NgDG24/Solar-MPPT-BMS-System/Image/LTC4366/Front.png

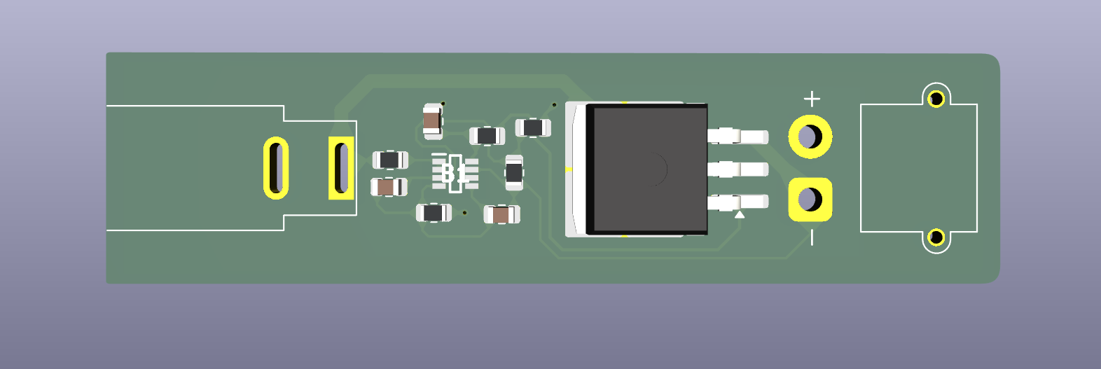
Image/LTC4366/Front.png
