NgDG24/Solar-MPPT-BMS-System/Image/LTC4162/Back.png

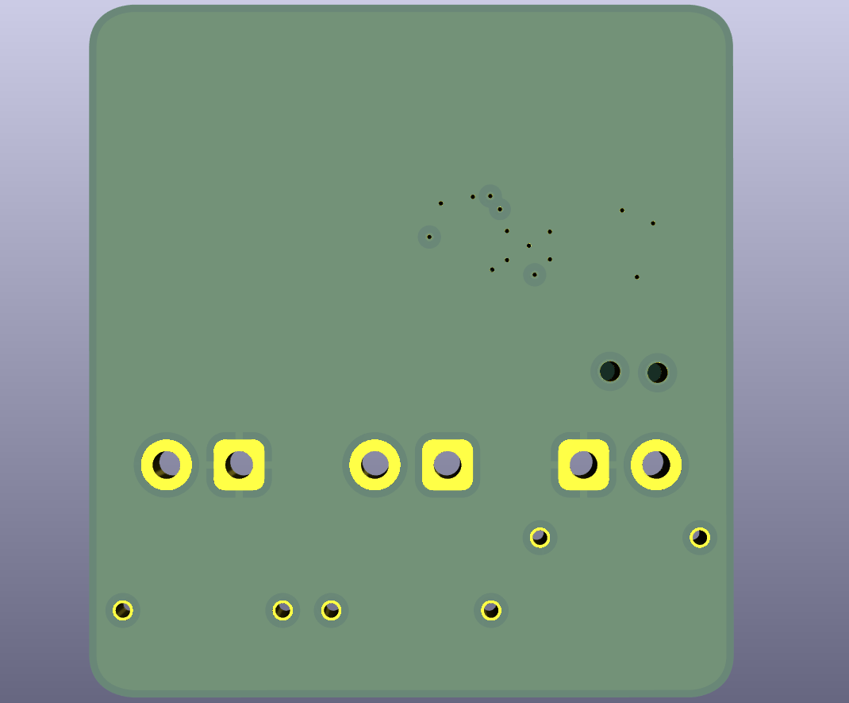
Image/LTC4162/Back.png
