NgDG24/Solar-MPPT-BMS-System/LTC4162/production/bom.csv

Designator | Footprint | Quantity | Value | LCSC Part #
B4 | QFN50P400X500X80-29N-D | 1 | LTC4162EUFD-LAD#PBF
C14 | 0805 | 1 | 4.7µF
C15 | 0805 | 1 | 1µF
C16, C17 | 0805 | 2 | 10µF
C5 | 0805 | 1 | 22nF
J1 | AMASS_XT30U-F_1x02_P5.0mm_Vertical | 1 | Conn_01x02
J2, J3 | AMASS_XT30U-M_1x02_P5.0mm_Vertical | 2 | Conn_01x02
L2 | L_Coilcraft_XAL5030-XXX | 1 | 6.8µH
NTCS0402E3103FLT2 | 0402 | 1 | 10k
Q6 | SOIC127P600X175-8N | 1 | AO4406A
Q7 | SOT-23 | 1 | 2N7002
R8 | 0805 | 1 | 10k
R9 | 0805 | 1 | 63.4k
RSNSB2 | R_Shunt_Vishay_WSK2512_6332Metric_T1.19mm | 1 | 10mΩ
RSNSI2 | R_Shunt_Vishay_WSK2512_6332Metric_T1.19mm | 1 | 16mΩ
