NgDG24/Solar-MPPT-BMS-System/MAX17302/MAX17302.csv

Reference | Qty | Value | DNP | Exclude from BOM | Exclude from Board | Footprint | Datasheet
C1,C3,C4 | 3 | 0.1 µF |  |  |  | Capacitor_SMD:C_0805_2012Metric
C2 | 1 | 0.47µF |  |  |  | Capacitor_SMD:C_0805_2012Metric
J1,J2 | 2 | Conn_01x02 |  |  |  | Connector_AMASS:AMASS_XT30U-F_1x02_P5.0mm_Vertical
J3 | 1 | Conn_01x03 |  |  |  | Connector_PinHeader_2.54mm:PinHeader_1x03_P2.54mm_Vertical_SMD_Pin1Left
Q3 | 1 | FS8205A |  |  |  | Package_SO:TSSOP-8_4.4x3mm_P0.65mm | https://aosmd.com/sites/default/files/res/data_sheets/AO4842.pdf
R1 | 1 | 10Ω |  |  |  | Resistor_SMD:R_0805_2012Metric
R2 | 1 | 10mΩ |  |  |  | Resistor_SMD:R_Shunt_Ohmite_LVK12
R3,R4 | 2 | 1k |  |  |  | Resistor_SMD:R_0805_2012Metric
TH1 | 1 | 10kΩ |  |  |  | Resistor_SMD:R_0805_2012Metric
U1 | 1 | MAX17302G+T |  |  |  | Max17302:21-0137I_T1433-2_MXM | MAX17302G+T
