NgDG24/Solar-MPPT-BMS-System/LTC4162/KiCad/User Library-XT30PW-F.STEP

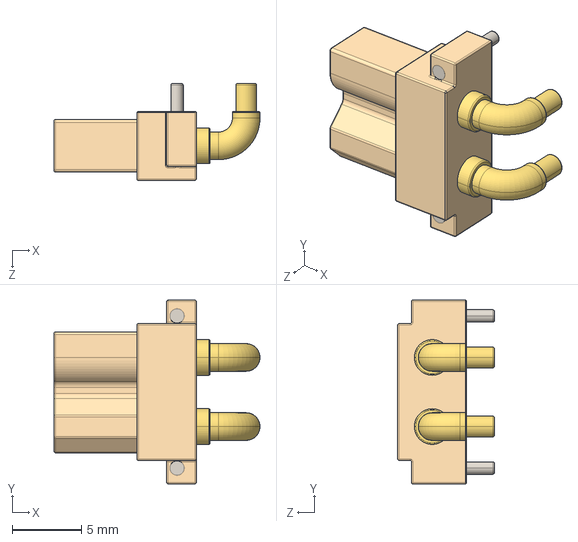
[picture p3: CAD file, 2026-10-14]
LTC4162/KiCad/User Library-XT30PW-F.STEP
14.9 x 13.3 x 7.00 mm
