NgDG24/Solar-MPPT-BMS-System/LTC4162/KiCad/FDMC86139P.stp

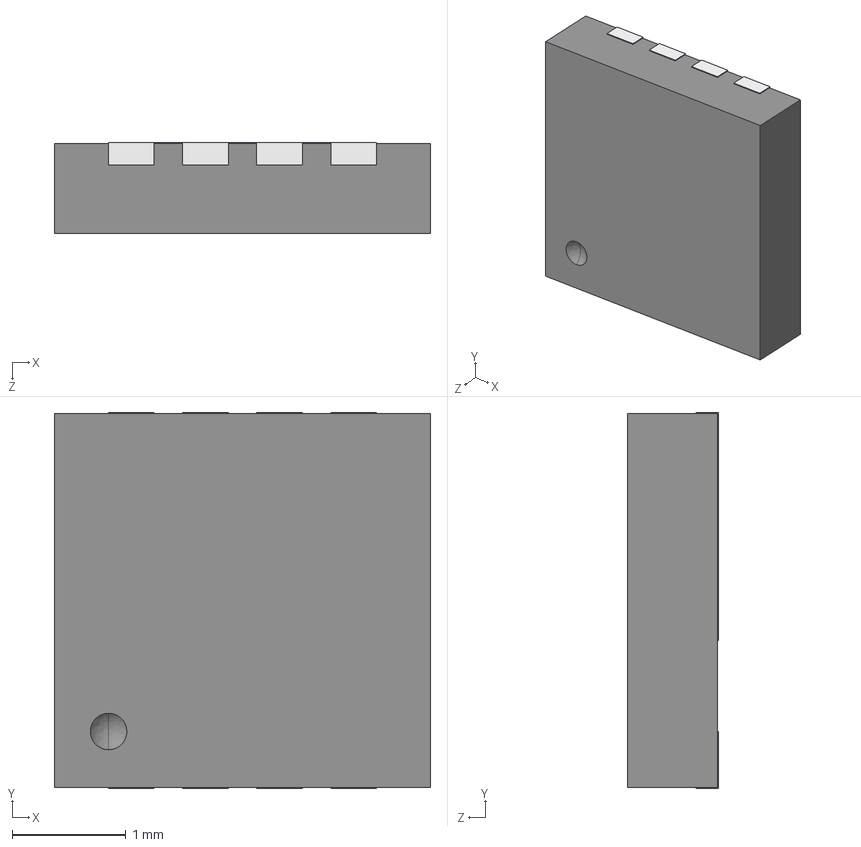
[picture p4: CAD file, 2026-10-14]
LTC4162/KiCad/FDMC86139P.stp
3.30 x 3.30 x 0.8 mm
