NgDG24/Solar-MPPT-BMS-System/LTC4162/KiCad/21-0137I_T1433-2_MXM.step

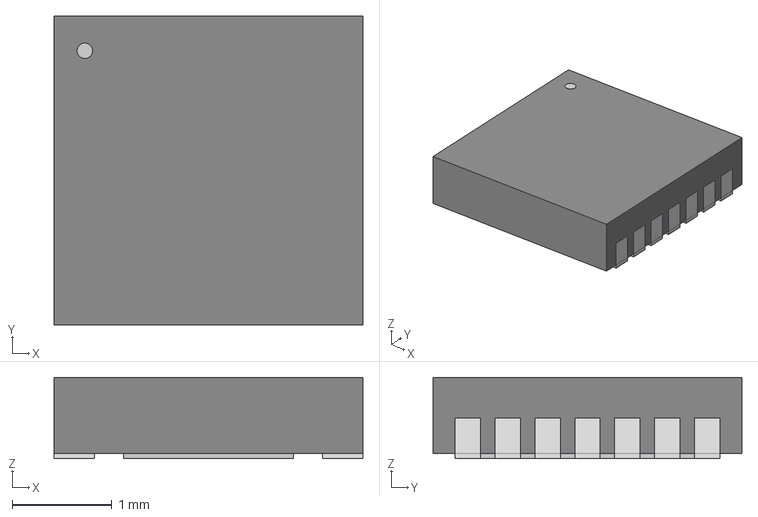
[picture p5: CAD file, 2026-10-14]
LTC4162/KiCad/21-0137I_T1433-2_MXM.step
3.10 x 3.10 x 0.815 mm
