NgDG24/Solar-MPPT-BMS-System/LTC4162/KiCad/User Library-XT30PW-M.STEP

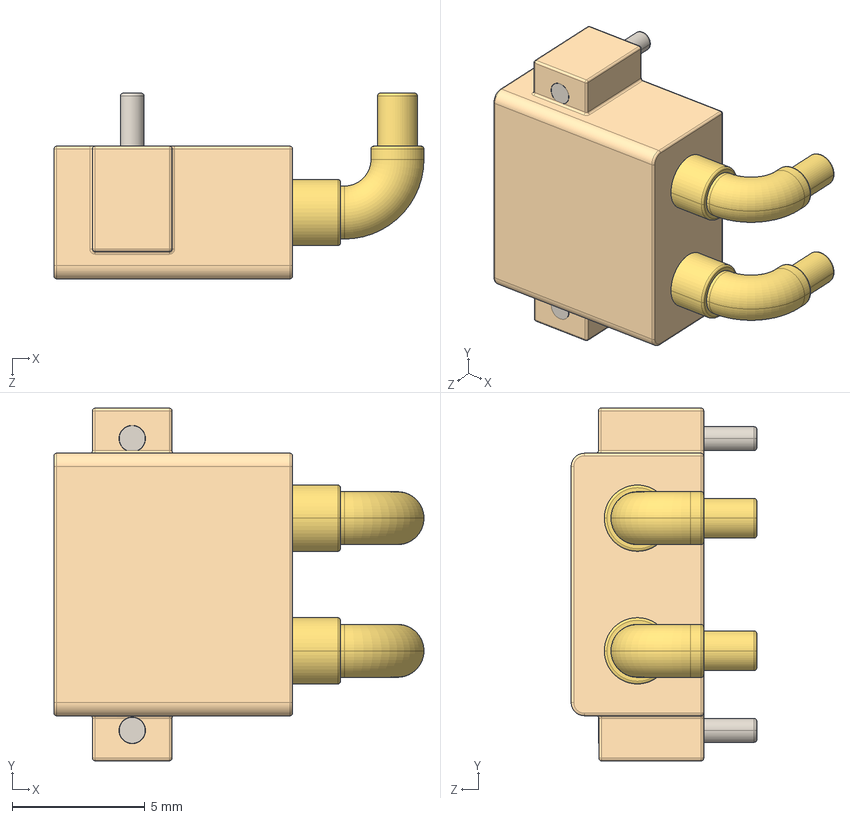
[picture p6: CAD file, 2026-10-14]
LTC4162/KiCad/User Library-XT30PW-M.STEP
13.9 x 13.3 x 7.00 mm
