NgDG24/Solar-MPPT-BMS-System/LTC4162/KiCad/Vishay_CSM2512_CSM2512S.STEP

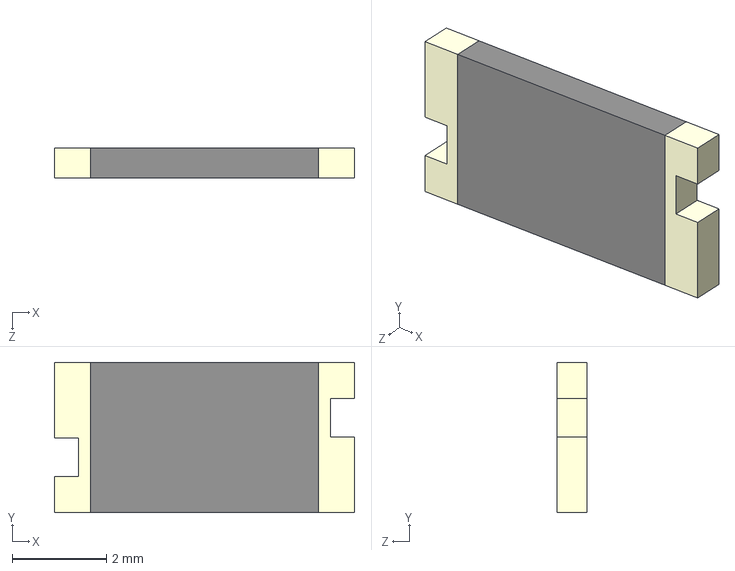
[picture p7: CAD file, 2026-10-14]
LTC4162/KiCad/Vishay_CSM2512_CSM2512S.STEP
6.35 x 3.17 x 0.635 mm
