NgDG24/Solar-MPPT-BMS-System/LTC4162/KiCad/05-08-1637_ADI.step

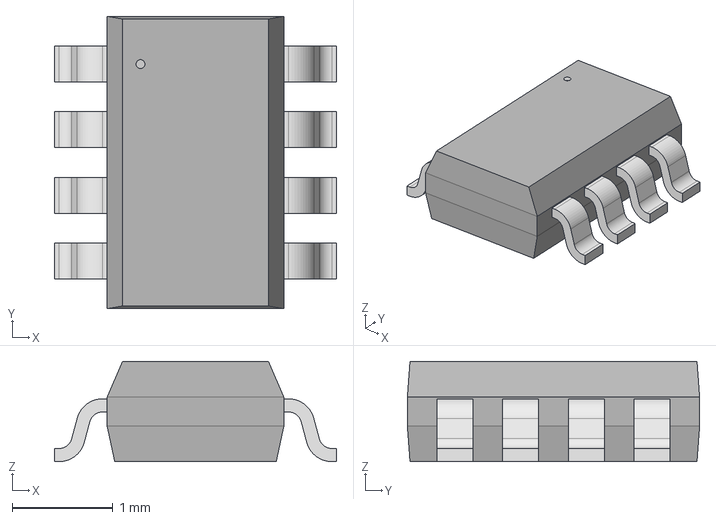
[picture p8: CAD file, 2026-10-14]
LTC4162/KiCad/05-08-1637_ADI.step
2.79 x 2.90 x 0.993 mm
