NgDG24/Solar-MPPT-BMS-System/MAX17302/MAX17302.pdf

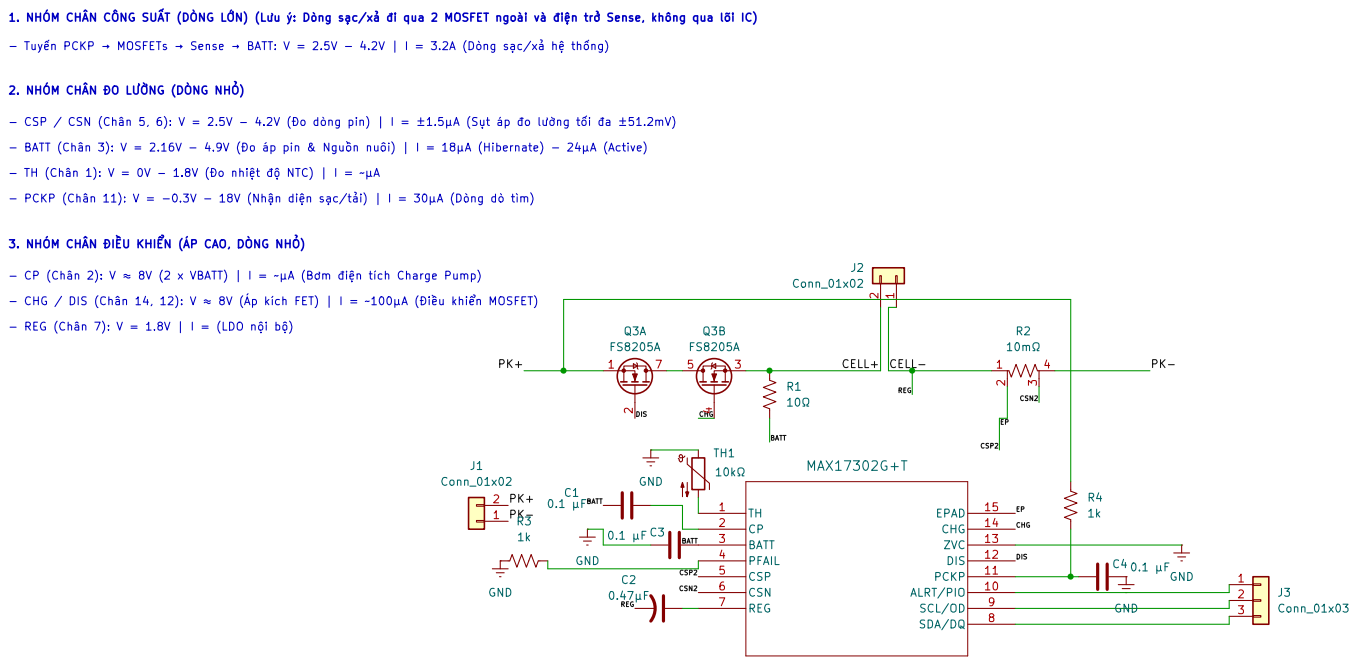
[picture p9: page 1]
