NgDG24/Solar-MPPT-BMS-System/(list of files, drawings)

Other design files:
LTC4162/temp-freerouting.dsn
