NgDG24/Solar-MPPT-BMS-System/MAX17302/MAX17302.kicad_pcb

## KiCad design MAX17302/MAX17302.kicad_pcb (2026-10-14)

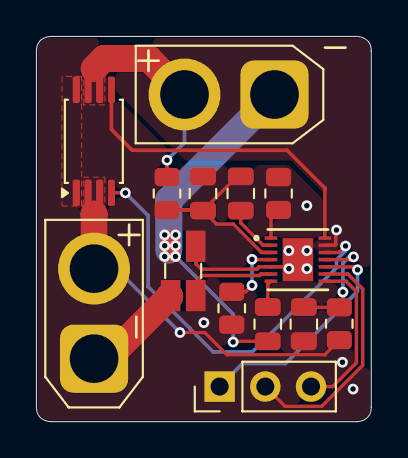
[picture p10: board MAX17302.kicad_pcb from above]

Board: 2 copper layers, 18.6 x 21.4 mm, 14 parts (0 on the bottom side), 19 nets.

Parts:
C1, C3, C4: 0.1 µF; C_0805_2012Metric
C2: 0.47µF; C_0805_2012Metric
J1, J2: Conn_01x02; AMASS_XT30U-F_1x02_P5.0mm_Vertical
J3: Conn_01x03; PinHeader_1x03_P2.54mm_Vertical
Q3: FS8205A; TSSOP-8_4.4x3mm_P0.65mm
R1: 10Ω; R_0805_2012Metric
R2: 10mΩ; R_Shunt_Ohmite_LVK12
R3, R4: 1k; R_0805_2012Metric
TH1: 10kΩ; R_0805_2012Metric
U1: MAX17302G+T; 21-0137I_T1433-2_MXM

Connections:
/BATT: C1.1, C3.2, R1.1, U1.3 (BATT)
/CELL+: J2.2, Q3.6 (D2), Q3.7 (D1), R1.2
/CELL-: C2.2, J2.1, R2.1
/CHG: Q3.5 (D2), U1.14 (CHG)
/CSN2: R2.3, U1.6 (CSN)
/CSP2: R2.2, U1.5 (CSP), U1.15 (EPAD)
/DIS: Q3.4 (G2), U1.12 (DIS)
/PK+: J1.2, Q3.2 (G1), Q3.3 (S2), R4.1
/PK-: J1.1, R2.4
DRAIN: Q3.1 (S1), Q3.8 (D1)
GND: C3.1, C4.1, R3.1, TH1.1, U1.13 (ZVC)
unnamed: J3.1, U1.10 (ALRT/PIO)
unnamed: J3.2, U1.9 (SCL/OD)
unnamed: J3.3, U1.8 (SDA/DQ)
unnamed: C1.2, U1.2 (CP)
unnamed: C4.2, R4.2, U1.11 (PCKP)
unnamed: R3.2, U1.4 (PFAIL)
unnamed: C2.1, U1.7 (REG)
unnamed: TH1.2, U1.1 (TH)
