NgDG24/Solar-MPPT-BMS-System/LTC4162/LTC4162.kicad_pcb

## KiCad design LTC4162/LTC4162.kicad_pcb (2026-10-14)

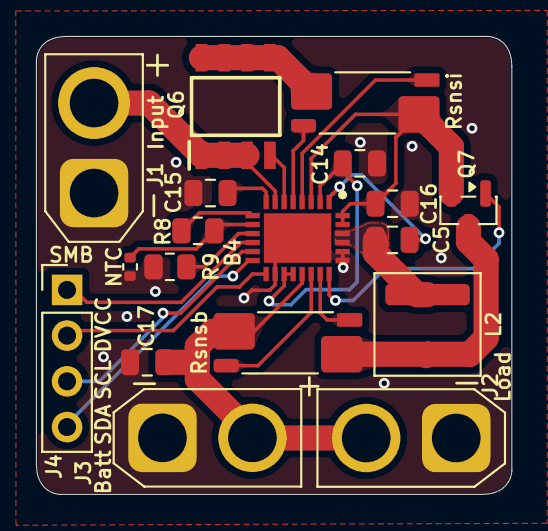
[picture p11: board LTC4162.kicad_pcb from above]

Board: 2 copper layers, 26.4 x 25.4 mm, 18 parts (0 on the bottom side), 23 nets.

Parts:
B4: LTC4162EUFD-LAD#PBF; QFN50P400X500X80-29N-D
C5: 22nF; C_0805_2012Metric
C14: 4.7µF; C_0805_2012Metric
C15: 1µF; C_0805_2012Metric
C16, C17: 10µF; C_0805_2012Metric
J1: Conn_01x02; AMASS_XT30U-F_1x02_P5.0mm_Vertical
J2, J3: Conn_01x02; AMASS_XT30U-M_1x02_P5.0mm_Vertical
J4: Conn_01x04; PinHeader_1x04_P2.54mm_Vertical
L2: 6.8µH; L_Coilcraft_XAL5030-XXX
NTC: 10k; R_0402_1005Metric
Q6: AO4406A; SOIC127P600X175-8N
Q7: 2N7002; SOT-23
R8: 10k; R_0805_2012Metric
R9: 63.4k; R_0805_2012Metric
Rsnsb: 10mΩ; R_Shunt_Vishay_WSK2512_6332Metric_T1.19mm
Rsnsi: 16mΩ; R_Shunt_Vishay_WSK2512_6332Metric_T1.19mm

Connections:
/PK+: B4.19 (BATSENS+), C17.2, J2.2, J3.2, Rsnsb.4
/Vin LTC4162: B4.7 (VIN), J1.2, Q6.1 (G), Q6.2 (D), Q6.3 (S)
GND: B4.16 (SYNC), B4.23 (PGND_1), B4.24 (PGND_2), B4.29 (AGND), C14.2, C15.1, C16.1, C17.1, J1.1, J2.1, J3.1, NTC.2, R9.1
unnamed: B4.22 (BATFET), Q7.1 (G)
unnamed: B4.1 (BOOST), C5.2
unnamed: B4.2 (INTVCC), B4.17 (CELLS0), B4.18 (CELLS1), C14.1
unnamed: B4.4 (CLN), Rsnsi.2
unnamed: B4.5 (CLP), Rsnsi.3
unnamed: B4.20 (CSN), Rsnsb.3
unnamed: B4.21 (CSP), Rsnsb.2
unnamed: B4.15 (DVCC), J4.2
unnamed: B4.6 (INFET), Q6.4
unnamed: B4.10 (NTC), NTC.1, R8.1
unnamed: B4.9 (NTCBIAS), R8.2
unnamed: B4.11 (RT), R9.2
unnamed: B4.13 (SCL), J4.3
unnamed: B4.14 (SDA), J4.4
unnamed: B4.25 (SW_1), B4.26 (SW_2), C5.1, L2.1
unnamed: B4.8 (VCC2P5), C15.2
unnamed: B4.3 (VOUTA), B4.27 (VOUT_1), B4.28 (VOUT_2), C16.2, Q7.2 (D), Rsnsi.1
unnamed: B4.12 (~SMBALERT), J4.1
unnamed: Q6.5, Q6.6, Q6.7, Q6.8, Rsnsi.4
unnamed: L2.2, Q7.3 (S), Rsnsb.1
