NgDG24/Solar-MPPT-BMS-System/LTC4366/Saty.kicad_pcb

## KiCad design LTC4366/Saty.kicad_pcb (2026-10-14)

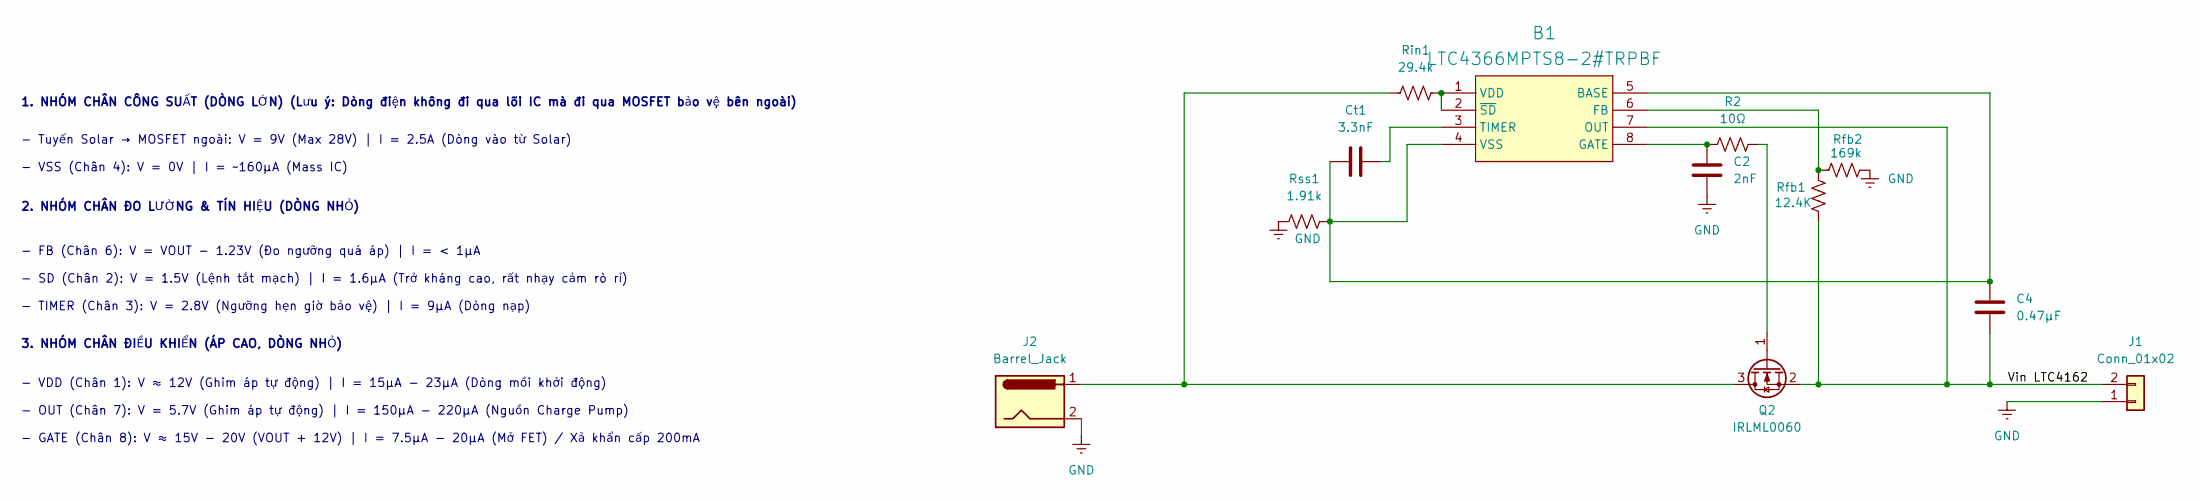
[picture p12: schematic Saty.kicad_sch, LTC4366]

Parts:
B1: LTC4366MPTS8-2#TRPBF; SOT65P280X100-8N; Manufacturer_Part_Number LTC4366MPTS8-2#TRPBF; Mouser Part Number 584-C4366MPTS8-2TPF
C2: 2nF; C_0805_2012Metric
C4: 0.47µF; C_0805_2012Metric
Ct1: 3.3nF; C_0805_2012Metric
J1: Conn_01x02; AMASS_XT30UPB-M_1x02_P5.0mm_Vertical
J2: Barrel_Jack; BarrelJack_GCT_DCJ200-10-A_Horizontal
Q2: IRLML0060; SOT-23
R2: 10Ω; R_0805_2012Metric
Rfb1: 12.4K; R_0805_2012Metric
Rfb2: 169k; R_0805_2012Metric
Rin1: 29.4k; R_0805_2012Metric
Rss1: 1.91k; R_0805_2012Metric

Connections:
/Vin LTC4162: B1.7 (OUT), C4.1, J1.2, Q2.2 (S), Rfb1.1
GND: C2.1, J1.1, J2.2, Rfb2.2, Rss1.2
unnamed: B1.4 (VSS), B1.5 (BASE), C4.2, Ct1.1, Rss1.1
unnamed: B1.6 (FB), Rfb1.2, Rfb2.1
unnamed: B1.8 (GATE), C2.2, R2.1
unnamed: B1.3 (TIMER), Ct1.2
unnamed: B1.1 (VDD), B1.2 (~SD), Rin1.1
unnamed: J2.1, Q2.3 (D), Rin1.2
unnamed: Q2.1 (G), R2.2

Notes on the sheet:
3. NHÓM CHÂN ĐIỀU KHIỂN (ÁP CAO, DÒNG NHỎ)
2. NHÓM CHÂN ĐO LƯỜNG & TÍN HIỆU (DÒNG NHỎ)
1. NHÓM CHÂN CÔNG SUẤT (DÒNG LỚN) (Lưu ý: Dòng điện không đi qua lõi IC mà đi qua MOSFET bảo vệ bên ngoài)
- FB (Chân 6): V = VOUT - 1.23V (Đo ngưỡng quá áp) | I = < 1µA - SD (Chân 2): V = 1.5V (Lệnh tắt mạch) | I = 1.6µA (Trở kháng cao, rất nhạy cảm rò rỉ) - TIMER (Chân 3): V = 2.8V (Ngưỡng hẹn giờ bảo vệ) | I = 9µA (Dòng nạp)
- Tuyến Solar → MOSFET ngoài: V = 9V (Max 28V) | I = 2.5A (Dòng vào từ Solar) - VSS (Chân 4): V = 0V | I = ~160µA (Mass IC)
- VDD (Chân 1): V ≈ 12V (Ghim áp tự động) | I = 15µA - 23µA (Dòng mồi khởi động) - OUT (Chân 7): V = 5.7V (Ghim áp tự động) | I = 150µA - 220µA (Nguồn Charge Pump) - GATE (Chân 8): V ≈ 15V - 20V (VOUT + 12V) | I = 7.5µA - 20µA (Mở FET) / Xả khẩn cấp 200mA

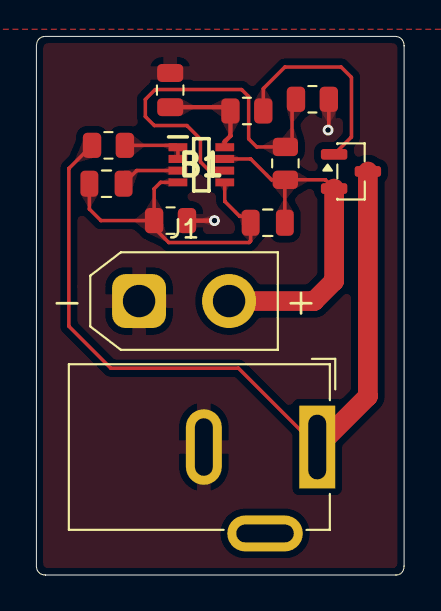
[picture p13: board Saty.kicad_pcb from above]

Board: 2 copper layers, 20.4 x 29.9 mm, 12 parts (0 on the bottom side), 9 nets.
