NgDG24/Solar-MPPT-BMS-System/(commit log)

2026-06-30 Revise README with enhanced project details
    Updated project title and expanded project overview with detailed hardware architecture and PCB layout techniques.
2026-07-18 update the pcb layout of LTC4366
    fixes clearance
    fixes length
    fixes track width
2026-07-18 Update PCB layout and add NTC thermistor
    - Resolved clearance issues to ensure design safety.
    - Adjusted trace widths for better routing.
    - Optimized component placements and overall layout.
    - Added NTC thermistor for temperature monitoring.
2026-07-29 Rebuild the MAX17302 PCB
    also add new 3D of MAX17302
2026-10-14 Sync local: KiCad LTC4162/LTC4366/MAX17302 + production + Image, add .gitignore (ignore .history, *-backups, *.lck), restore LICENSE/README from origin/main
